zhangsxphd/Rice_SapFlow/Rice_SapFlow_V01_PCB_Delivery_Report.md

# Rice_SapFlow_V01 PCB 当前交付状态

当前交付为修复后的布局候选与可复核检测证据，**不是可生产整板**。四块 PCB 的剩余违规和未连接数量见 `validation_summary.json` 及 `verification/AUDIT_REPORT.md`。旧“零错误、可下单”的报告已撤回。

已修复：主板加热电源与门极、地、FPC 焊盘的短接风险；测试点与安装孔重叠；部分器件间距；FPC 错误禁布设置、错误总长、无效且会跨越异网焊盘的六条横向走线。无效线被移除后仍须完成真实布线，不能把飞线隐藏当作连接完成。

BOM 已修正型号与采购号，CPL 从实际生成 PCB 的位置、旋转和层面读取；不再使用三种变体共用的硬编码坐标。CPL 只列装配 SMT 器件，排针、测试铜点、焊桥、安装孔和金手指不作为 SMT 贴装元件。

原始生产文件保存在 `verification/legacy_outputs/` 和完整原始备份内，属于失效历史输出。当前生成器在 DRC 和设计验证未完成时拒绝 CAM 发布。

原生 EasyEDA 重建和 KiCad 候选是不同文件版本。工程导出 ZIP 校验只能证明归档完整性，不证明重新导入、PCB 一致性或生产适用性。当前不支持宣称 KiCad 10 文件可无缝导入嘉立创 EDA。
