zhangsxphd/Rice_SapFlow/.easyeda/artifacts/20261003-015003-pcb_snapshot-f651ff9e.png

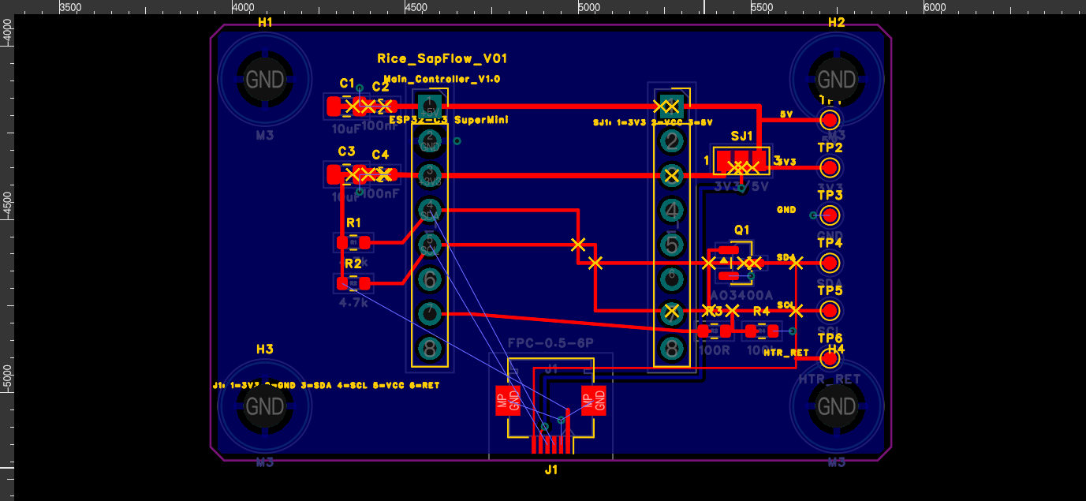
.easyeda/artifacts/20261003-015003-pcb_snapshot-f651ff9e.png
