zhangsxphd/Rice_SapFlow/.easyeda/artifacts/20261003-015355-schematic_export-27b97df9.png

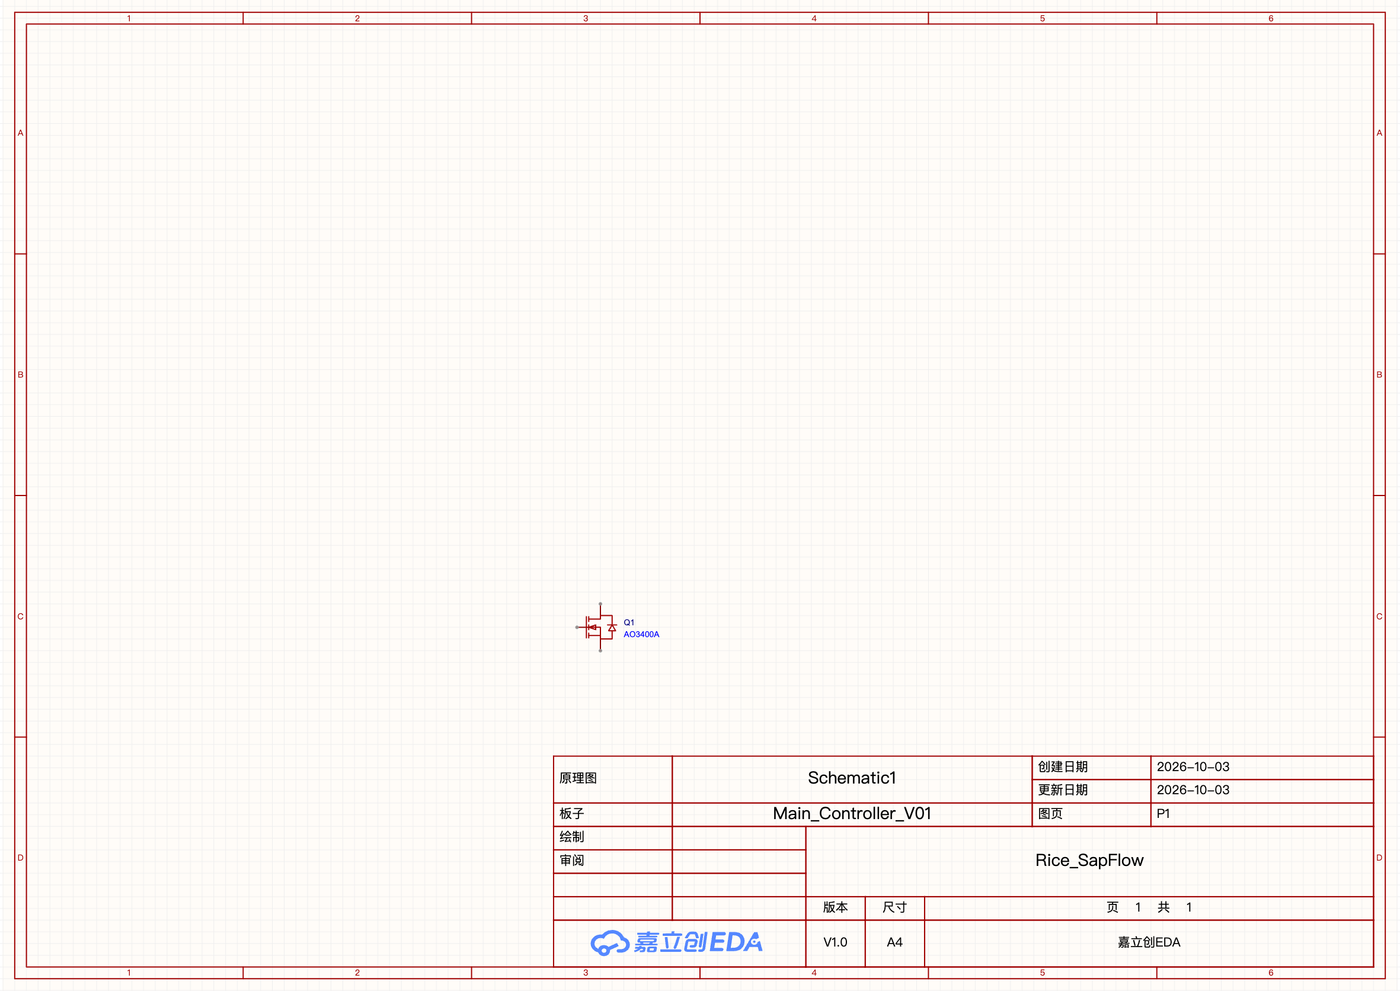
.easyeda/artifacts/20261003-015355-schematic_export-27b97df9.png
