zhangsxphd/Rice_SapFlow/.easyeda/artifacts/20261003-015553-schematic_export-b0486d70.png

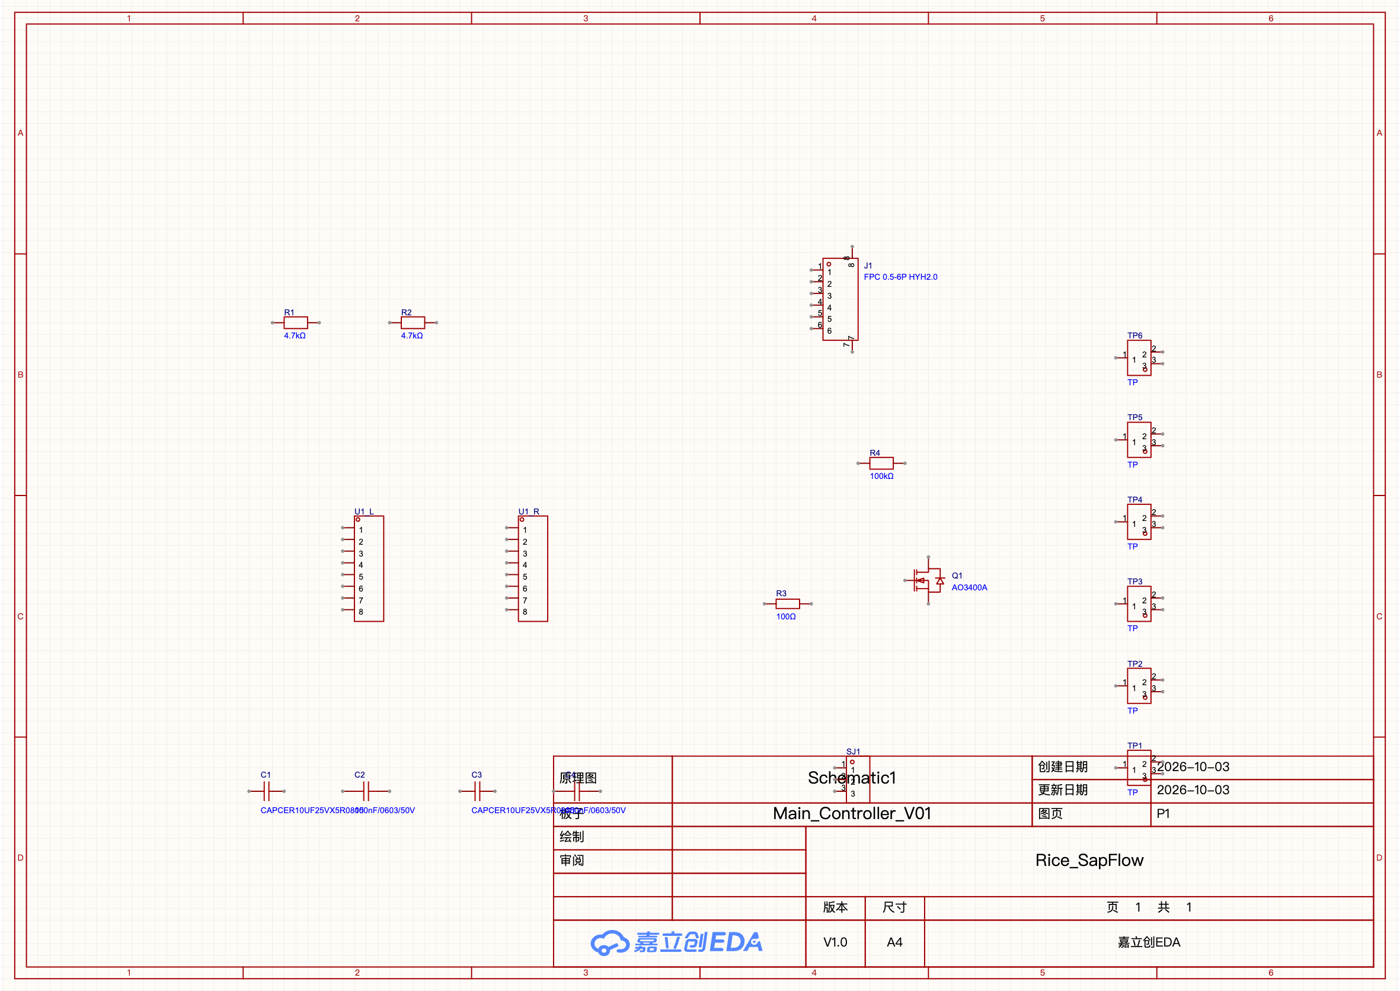
.easyeda/artifacts/20261003-015553-schematic_export-b0486d70.png
