zhangsxphd/Rice_SapFlow/.easyeda/artifacts/20261003-193253-schematic_export-cc84f5fa.png

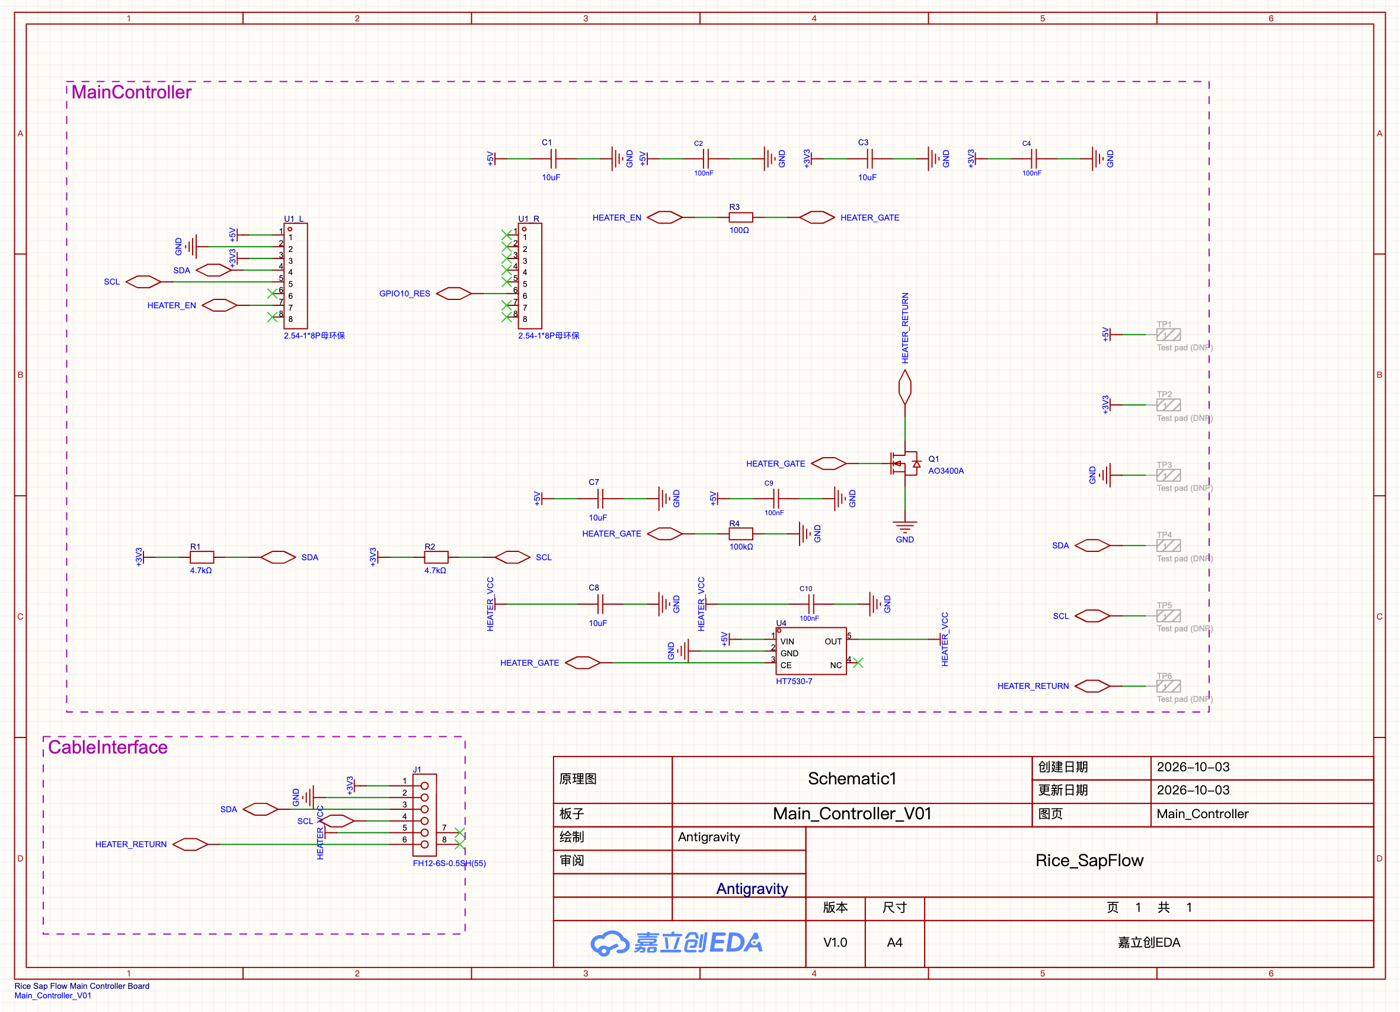
.easyeda/artifacts/20261003-193253-schematic_export-cc84f5fa.png
