zhangsxphd/Rice_SapFlow/.easyeda/artifacts/20261003-193310-schematic_export-c47cb14c.png

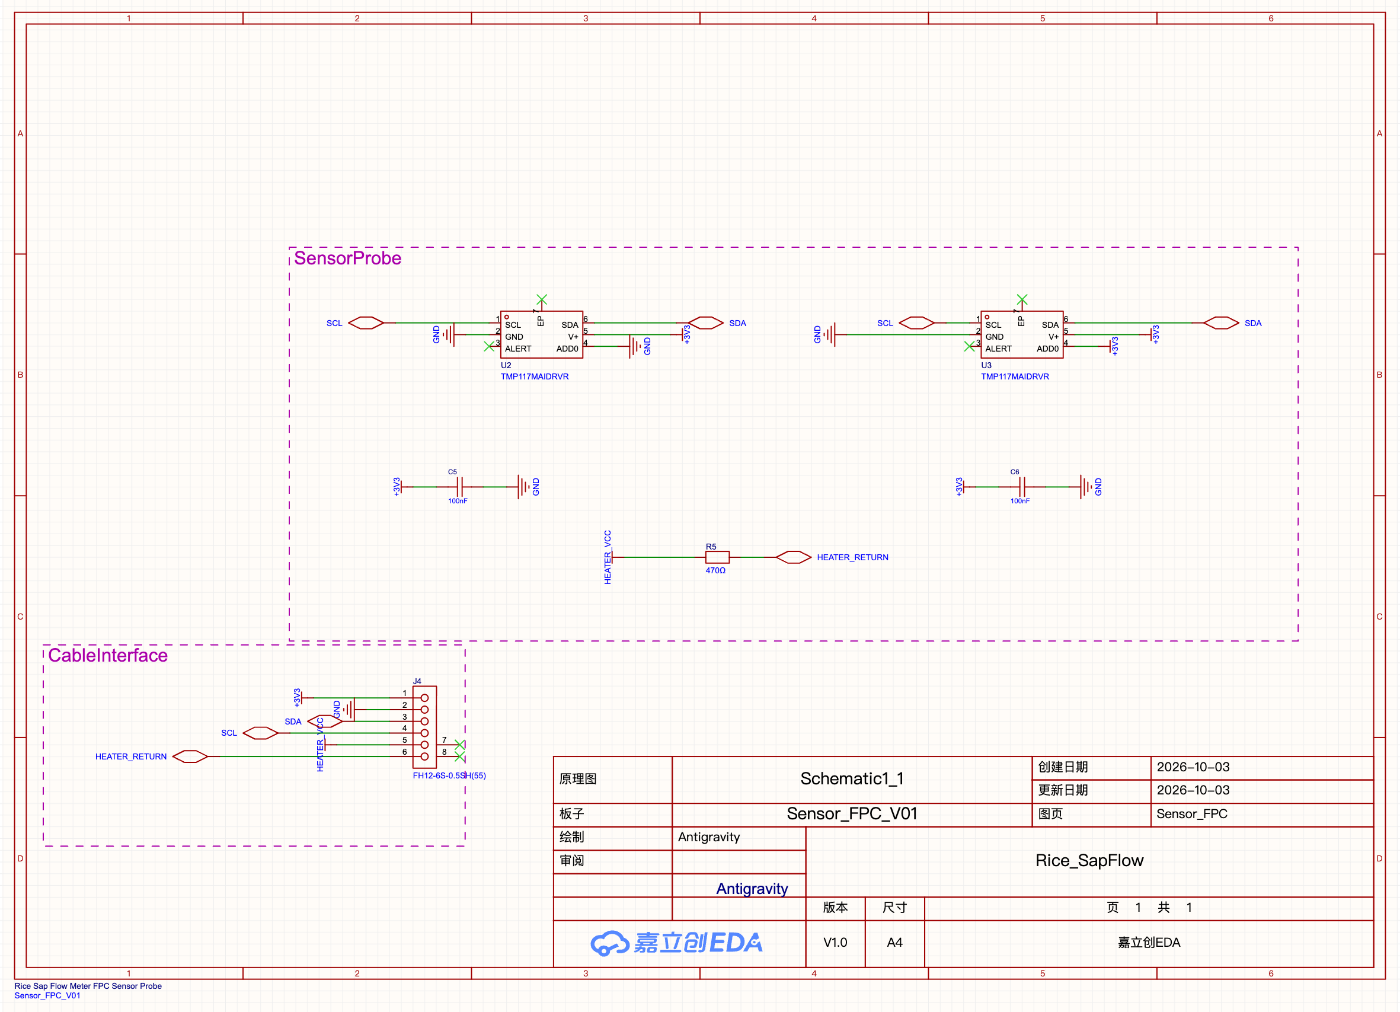
.easyeda/artifacts/20261003-193310-schematic_export-c47cb14c.png
