zhangsxphd/Rice_SapFlow/.easyeda/artifacts/20261003-195301-schematic_export-f0e2b212.png

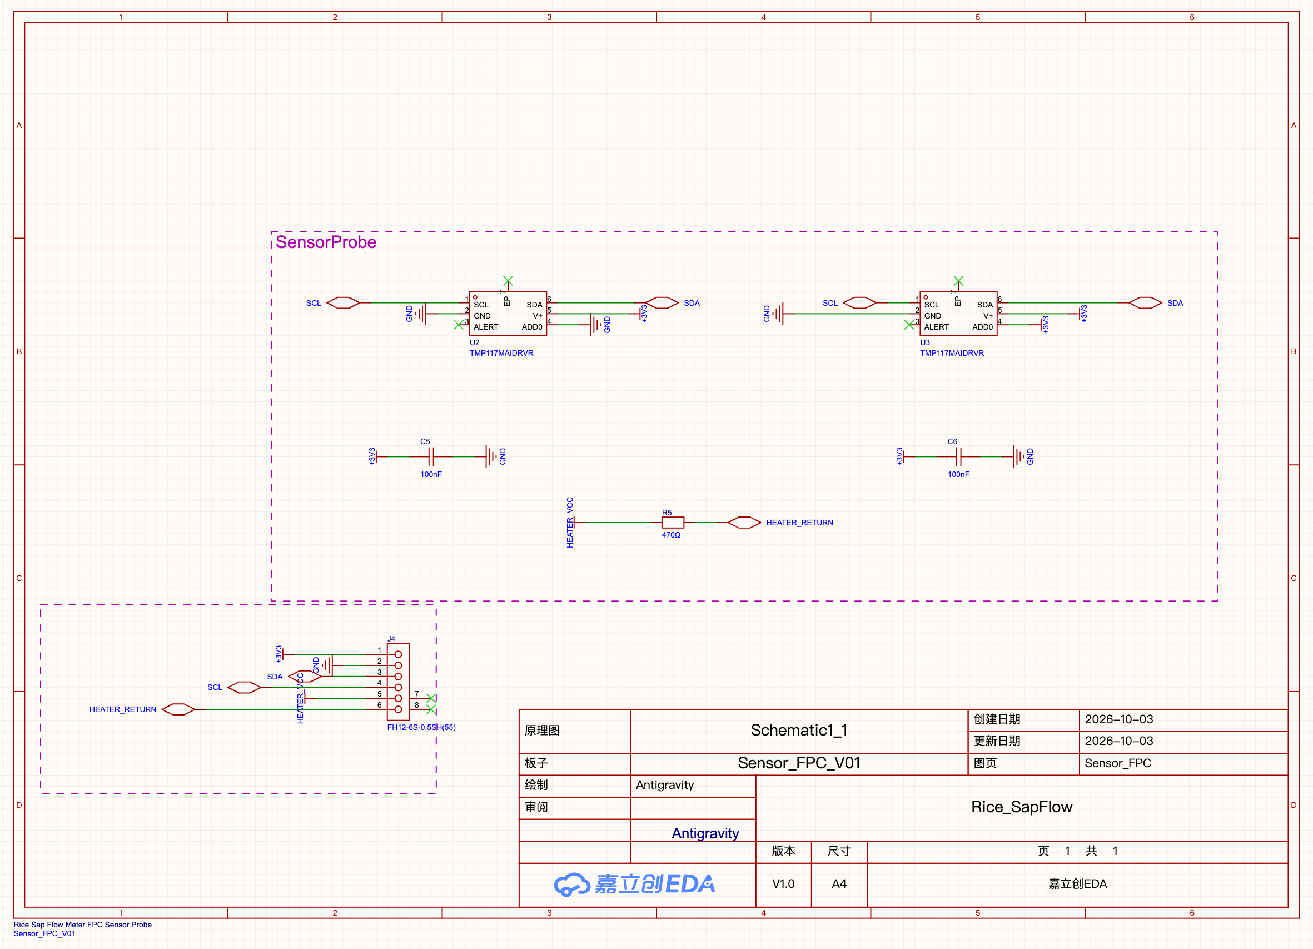
.easyeda/artifacts/20261003-195301-schematic_export-f0e2b212.png
