zhangsxphd/Rice_SapFlow/Main_Controller_V01_BOM.csv

No. | Quantity | Comment | Designator | Footprint | Value | Manufacturer Part | Manufacturer | Supplier Part | Supplier
1 | 2 | CAPCER10UF25VX5R0805 | C1,C3 | C0805 |  | CAPCER10UF25VX5R0805 |  | C9900012828 | LCSC
2 | 2 | 100nF/0603/50V | C2,C4 | C0603 |  | 100nF/0603/50V |  | C9900013340 | LCSC
3 | 1 | FPC 0.5-6P HYH2.0 | J1 | FPC-SMD_6P-P0.50_FPC-0.5-6P-HYH2.0 |  | FPC 0.5-6P HYH2.0 | SHOU HAN(首韩) | C6364657 | LCSC
4 | 1 | AO3400A | Q1 | SOT-23-3_L2.9-W1.3-P1.90-LS2.4-BR |  | AO3400A | HUASHUO(华朔) | C700953 | LCSC
5 | 2 | 4.7kΩ | R1,R2 | R0603 | 4.7kΩ | HoLTT0603-1/10W-4.7K-1% | Milliohm(毫欧) | C2904521 | LCSC
6 | 1 | 100Ω | R3 | R0603 | 100Ω | QR0603J100RP05Z | EVER OHMS(天二科技) | C176159 | LCSC
7 | 1 | 100kΩ | R4 | R0603 | 100kΩ | RT0603LRC07100KL | YAGEO(国巨) | C6668830 | LCSC
8 | 1 | HDR-M_2.54_1x3P | SJ1 | HDR-TH_3P-P2.54-V-M |  |  |  | C2937625
9 | 6 | TP | TP1,TP2,TP3,TP4,TP5,TP6 | CONN-TH_C9900013070 |  | TP |  | C9900013070 | LCSC
10 | 2 | HDR-M_2.54_1x8P | U1_L,U1_R | HDR-TH_8P-P2.54-V-M |  |  |  | C124381
