zhangsxphd/Rice_SapFlow/Rice_SapFlow_Complete_BOM.csv

No. | Quantity | Comment | Designator | Footprint | Value | Manufacturer Part | Manufacturer | Supplier Part | Supplier
1 | 2 | CAPCER10UF25VX5R0805 | C1,C3 | C0805 |  | CAPCER10UF25VX5R0805 |  | C9900012828 | LCSC
2 | 2 | 100nF/0603/50V | C2,C4 | C0603 |  | 100nF/0603/50V |  | C9900013340 | LCSC
3 | 2 | 100nF | C5,C6 | C0402 | 100nF | CL05B104KO5NNNC | SAMSUNG(三星) | C1525 | LCSC
4 | 1 | FPC 0.5-6P HYH2.0 | J1 | FPC-SMD_6P-P0.50_FPC-0.5-6P-HYH2.0 |  | FPC 0.5-6P HYH2.0 | SHOU HAN(首韩) | C6364657 | LCSC
5 | 1 | FH12-6S-0.5SH(55) | J4 | FPC-SMD_FH12-6S-0.5SH-55 |  | FH12-6S-0.5SH(55) | HRS(广濑) | C202118 | LCSC
6 | 1 | AO3400A | Q1 | SOT-23-3_L2.9-W1.3-P1.90-LS2.4-BR |  | AO3400A | HUASHUO(华朔) | C700953 | LCSC
7 | 2 | 4.7kΩ | R1,R2 | R0603 | 4.7kΩ | HoLTT0603-1/10W-4.7K-1% | Milliohm(毫欧) | C2904521 | LCSC
8 | 1 | 100Ω | R3 | R0603 | 100Ω | QR0603J100RP05Z | EVER OHMS(天二科技) | C176159 | LCSC
9 | 1 | 100kΩ | R4 | R0603 | 100kΩ | RT0603LRC07100KL | YAGEO(国巨) | C6668830 | LCSC
10 | 1 | PRF18BC471QB5RB | R5 | R0603 |  | PRF18BC471QB5RB | muRata(村田) | C152572 | LCSC
11 | 1 | HDR-M_2.54_1x3P | SJ1 | HDR-TH_3P-P2.54-V-M |  |  |  | C2937625
12 | 6 | TP | TP1,TP2,TP3,TP4,TP5,TP6 | CONN-TH_C9900013070 |  | TP |  | C9900013070 | LCSC
13 | 2 | HDR-M_2.54_1x8P | U1_L,U1_R | HDR-TH_8P-P2.54-V-M |  |  |  | C124381
14 | 2 | TMP117MAIDRVR | U2,U3 | WSON-6_L2.0-W2.0-P0.65-BL-EP |  | TMP117MAIDRVR | TI(德州仪器) | C2803242 | LCSC
