zhangsxphd/Rice_SapFlow/Main_Controller_V01/BOM_Main_Controller_V01.csv

Comment | Designator | Footprint | LCSC Part #
ESP32-C3 Super Mini Socket (1x8 2.54mm Female Header) | U1_L, U1_R | PinSocket_1x08_P2.54mm_Vertical | C42431840
AO3400A N-MOSFET SOT-23 30V 5.7A | Q1 | SOT-23 | C20917
4.7kΩ ±1% 0603 SMD Resistor (I2C Pull-Up) | R1, R2 | R_0603_1608Metric | C23162
100Ω ±1% 0603 SMD Resistor (Gate Damping) | R3 | R_0603_1608Metric | C22775
100kΩ ±1% 0603 SMD Resistor (Gate Pull-Down) | R4 | R_0603_1608Metric | C25803
10µF 50V X5R 0805 SMD Capacitor (GRM21BR61H106KE43L) | C1, C3 | C_0805_2012Metric | C440198
100nF 50V X7R 0603 SMD Capacitor | C2, C4 | C_0603_1608Metric | C14663
6P 0.5mm Horizontal Flip-Lock FPC Connector | J1 | Hirose_FH12-6S-0.5SH_1x06-1MP_P0.50mm_Horizontal | C202118
3-Pad Solder Jumper (Default OPEN; manually select one voltage) | SJ1 | SolderJumper-3_P1.3mm_Open_Pad1.0x1.5mm_NumberLabels | CUSTOM_SMD
Test Point SMD Pad D1.0mm | TP1, TP2, TP3, TP4, TP5, TP6 | TestPoint_Pad_D1.0mm | CUSTOM_TP
M3 Mounting Hole Dia 3.2mm | H1, H2, H3, H4 | MountingHole_3.2mm_M3 | MECHANICAL
