zhangsxphd/Rice_SapFlow/.easyeda/artifacts/20261003-195729-schematic_bom-09f4071b.csv

No. | Quantity | Comment | Designator | Footprint | Value | Manufacturer Part | Manufacturer | Supplier Part | Supplier
1 | 4 | 10uF | C1,C3,C7,C8 | C0805 | 10uF | GRM21BR61H106KE43L | muRata(村田) | C440198 | LCSC
2 | 4 | 100nF | C2,C4,C9,C10 | C0603 | 100nF | CC0603KRX7R9BB104 | YAGEO(国巨) | C14663 | LCSC
3 | 1 | FH12-6S-0.5SH(55) | J1 | FPC-SMD_FH12-6S-0.5SH-55 |  | FH12-6S-0.5SH(55) | HRS(广濑) | C202118 | LCSC
4 | 2 | 2.54-1*8P母环保 | J2,J3 | HDR-TH_8P-P2.54-V-F |  | 2.54-1*8P母环保 | BOOMELE(博穆精密) | C27438 | LCSC
5 | 1 | AO3400A | Q1 | SOT-23-3_L2.9-W1.3-P1.90-LS2.4-BR |  | AO3400A | HUASHUO(华朔) | C700953 | LCSC
6 | 2 | 4.7kΩ | R1,R2 | R0603 | 4.7kΩ | HoLTT0603-1/10W-4.7K-1% | Milliohm(毫欧) | C2904521 | LCSC
7 | 1 | 100Ω | R3 | R0603 | 100Ω | QR0603J100RP05Z | EVER OHMS(天二科技) | C176159 | LCSC
8 | 1 | 100kΩ | R4 | R0603 | 100kΩ | RT0603LRC07100KL | YAGEO(国巨) | C6668830 | LCSC
9 | 1 | HT7530-7 | U4 | SOT-23-5_L3.0-W1.7-P0.95-LS2.8-BL |  | HT7530-7 | HOLTEK(合泰/盛群) | C259866 | LCSC
