zhangsxphd/Rice_SapFlow/.easyeda/artifacts/20261003-195731-schematic_bom-70c68af2.csv

No. | Quantity | Comment | Designator | Footprint | Value | Manufacturer Part | Manufacturer | Supplier Part | Supplier
1 | 2 | 100nF | C5,C6 | C0402 | 100nF | CL05B104KO5NNNC | SAMSUNG(三星) | C1525 | LCSC
2 | 1 | FH12-6S-0.5SH(55) | J4 | FPC-SMD_FH12-6S-0.5SH-55 |  | FH12-6S-0.5SH(55) | HRS(广濑) | C202118 | LCSC
3 | 1 | 470Ω | R5 | R0603 | 470Ω | AC0603DR-07470RL | YAGEO(国巨) | C227500 | LCSC
4 | 2 | TMP117MAIDRVR | U2,U3 | WSON-6_L2.0-W2.0-P0.65-BL-EP |  | TMP117MAIDRVR | TI(德州仪器) | C2803242 | LCSC
