zhangsxphd/Rice_SapFlow/(list of files, drawings)

Other design files:
design/easyeda/custom_asset_bindings.json
design/easyeda/custom_asset_bindings_v2.json
design/easyeda/custom_assets.json
design/easyeda/finger_footprint.json
design/easyeda/finger_footprint_v2.json
design/easyeda/finger_symbol.json
design/easyeda/jumper_footprint.json
design/easyeda/jumper_footprint_v2.json
design/easyeda/jumper_symbol.json
design/easyeda/main_connect.json
design/easyeda/main_intent.json
design/easyeda/main_place.apply.json
design/easyeda/main_remainder.apply.json
design/easyeda/scaffold.apply.json
design/easyeda/sensor_connect.json
design/easyeda/sensor_intent.json
design/easyeda/sensor_place.apply.json
design/easyeda/testpoint_footprint.json
design/easyeda/testpoint_footprint_v2.json
design/easyeda/testpoint_symbol.json
verification/easyeda_actions.json
verification/easyeda_after_asset_attempt.json
verification/easyeda_board_copy.json
verification/easyeda_board_list_final.json
verification/easyeda_boards_after_copy.json
verification/easyeda_components_before.json
verification/easyeda_documents.json
verification/easyeda_documents_after_copy.json
verification/easyeda_documents_final.json
verification/easyeda_empty_export.json
verification/easyeda_health_final.json
verification/easyeda_library/C1523.json
verification/easyeda_library/C1525.json
verification/easyeda_library/C20917.json
verification/easyeda_library/C23162.json
verification/easyeda_library/C152572.json
verification/easyeda_library/C202118.json
verification/easyeda_library/C2803242.json
verification/easyeda_library/conn6_search2.json
verification/easyeda_library/conn6_search.json
verification/easyeda_library/FH12_device.json
verification/easyeda_library/finger_create_recheck.json
verification/easyeda_library/finger_device_create.json
verification/easyeda_library/finger_device_v2_create.json
verification/easyeda_library/finger_footprint_build.json
verification/easyeda_library/finger_footprint_create.json
verification/easyeda_library/finger_footprint_v2_build.json
verification/easyeda_library/finger_footprint_v2_create.json
verification/easyeda_library/finger_invalid_device_delete.json
verification/easyeda_library/finger_personal_create.json
verification/easyeda_library/finger_symbol_build.json
verification/easyeda_library/finger_symbol_create.json
verification/easyeda_library/Jumper3_device.json
verification/easyeda_library/jumper_device_create.json
verification/easyeda_library/jumper_device_v2_create.json
verification/easyeda_library/jumper_footprint_build.json
verification/easyeda_library/jumper_footprint_create.json
verification/easyeda_library/jumper_footprint_v2_build.json
verification/easyeda_library/jumper_footprint_v2_create.json
verification/easyeda_library/jumper_search.json
verification/easyeda_library/jumper_symbol_build.json
verification/easyeda_library/jumper_symbol_create.json
verification/easyeda_library/libraries.json
verification/easyeda_library/resolved_remaining.json
verification/easyeda_library/selected_parts.json
verification/easyeda_library/sj_search2.json
verification/easyeda_library/testpoint_device_create.json
verification/easyeda_library/testpoint_device_v2_create.json
verification/easyeda_library/testpoint_footprint_build.json
verification/easyeda_library/testpoint_footprint_create.json
verification/easyeda_library/testpoint_footprint_v2_build.json
verification/easyeda_library/testpoint_footprint_v2_create.json
verification/easyeda_library/testpoint_search.json
verification/easyeda_library/testpoint_symbol_build.json
verification/easyeda_library/testpoint_symbol_create.json
verification/easyeda_library/TMP117_device.json
verification/easyeda_library/TMP117_symbol.json
verification/easyeda_library/TP_device.json
verification/easyeda_library/tp_search2.json
verification/easyeda_main_after_place_failure.json
verification/easyeda_main_after_remainder.json
verification/easyeda_main_connect_apply.json
verification/easyeda_main_connect_plan.json
verification/easyeda_main_current.json
verification/easyeda_main_fresh_final.json
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
