zhangsxphd/Rice_SapFlow/Sensor_FPC_V01/Sensor_FPC_4MM/Sensor_FPC_4MM.kicad_pcb

## KiCad design Sensor_FPC_V01/Sensor_FPC_4MM/Sensor_FPC_4MM.kicad_pcb (2026-10-04)

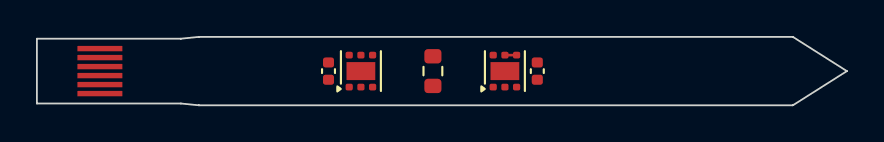
[picture p13: board Sensor_FPC_4MM.kicad_pcb from above]

Board: 2 copper layers, 45.0 x 3.8 mm, 6 parts (0 on the bottom side), 6 nets.

Parts:
C1, C2: 100nF; C_0402_1005Metric
J1_FPC: GoldFinger_6P
R_HEAT: PTC_470R; R_0603_1608Metric
U1: TMP117_UP; WSON-6-1EP_2x2mm_P0.65mm_EP1x1.6mm
U2: TMP117_DN; WSON-6-1EP_2x2mm_P0.65mm_EP1x1.6mm

Connections:
+3V3: C1.1, C2.1, J1_FPC.1, U1.5, U2.4, U2.5
GND: C1.2, C2.2, J1_FPC.2, U1.2, U1.4, U2.2
HEATER_RETURN: J1_FPC.6, R_HEAT.2
HEATER_VCC: J1_FPC.5, R_HEAT.1
SCL: J1_FPC.4, U1.1, U2.1
SDA: J1_FPC.3, U1.6, U2.6
