zhangsxphd/Rice_SapFlow/Main_Controller_V01/Main_Controller_V01.kicad_pcb

## KiCad design Main_Controller_V01/Main_Controller_V01.kicad_pcb (2026-10-04)

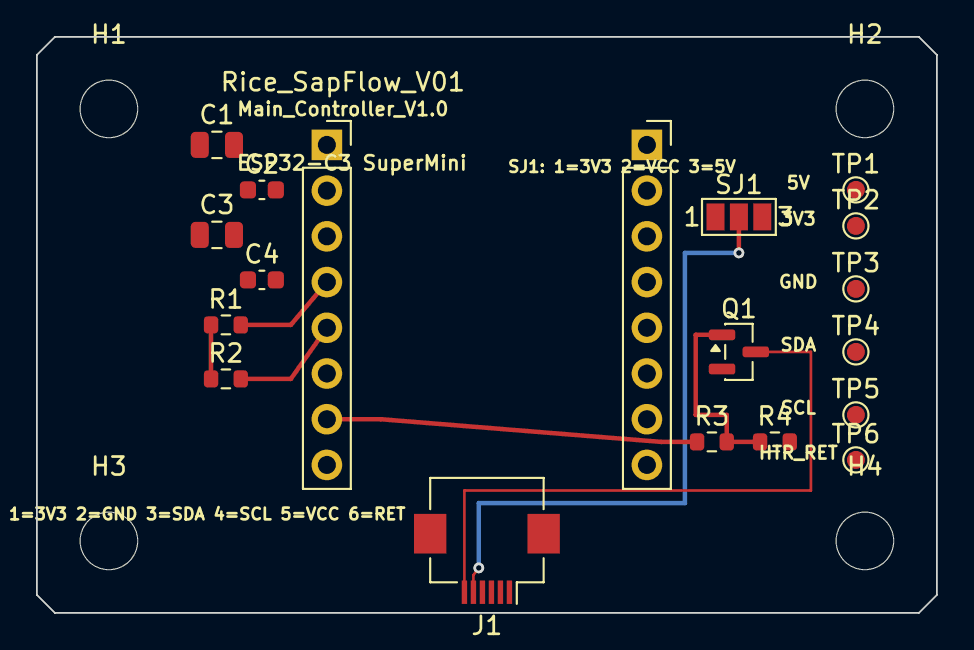
[picture p14: board Main_Controller_V01.kicad_pcb from above]

Board: 2 copper layers, 50.0 x 32.0 mm, 23 parts (0 on the bottom side), 9 nets.

Parts:
C1, C3: 10uF; C_0805_2012Metric
C2, C4: 100nF; C_0603_1608Metric
H1, H2, H3, H4: M3; MountingHole_3.2mm_M3
J1: FPC-0.5-6P; Hirose_FH12-6S-0.5SH_1x06-1MP_P0.50mm_Horizontal
Q1: AO3400A; SOT-23
R1, R2: 4.7k; R_0603_1608Metric
R3: 100R; R_0603_1608Metric
R4: 100k; R_0603_1608Metric
SJ1: 3V3/5V; SolderJumper-3_P1.3mm_Open_Pad1.0x1.5mm_NumberLabels
TP1: 5V; TestPoint_Pad_D1.0mm
TP2: 3V3; TestPoint_Pad_D1.0mm
TP3: GND; TestPoint_Pad_D1.0mm
TP4: SDA; TestPoint_Pad_D1.0mm
TP5: SCL; TestPoint_Pad_D1.0mm
TP6: HTR_RET; TestPoint_Pad_D1.0mm
U1_L: SuperMini_L; PinSocket_1x08_P2.54mm_Vertical
U1_R: SuperMini_R; PinSocket_1x08_P2.54mm_Vertical

Connections:
+3V3: C3.1, C4.1, J1.1, R1.1, R2.1, SJ1.1, TP2.1, U1_L.3
+5V: C1.1, C2.1, SJ1.3, TP1.1, U1_L.1
GND: C1.2, C2.2, C3.2, C4.2, J1.2, J1.MP, Q1.2, R4.2, TP3.1, U1_L.2
HEATER_EN: R3.1, U1_L.7
HEATER_GATE: Q1.1, R3.2, R4.1
HEATER_RETURN: J1.6, Q1.3, TP6.1
HEATER_VCC: J1.5, SJ1.2
SCL: J1.4, R2.2, TP5.1, U1_L.5
SDA: J1.3, R1.2, TP4.1, U1_L.4
