zhangsxphd/Rice_SapFlow/(notices)

Notices in the files:
README.md:
License: MIT
